Dovgalyuk/RelayComputerKit/README.md

# Релейный конструктор

Скомпилированный учебник и gerber-файлы для изготовления плат:
