Dovgalyuk/RelayComputerKit/labs/labs.tex

\documentclass[openany]{book}

\usepackage[a4paper]{geometry}

\usepackage[T2A]{fontenc}
\usepackage[utf8]{inputenc}
\usepackage[english,russian]{babel}

\usepackage{graphicx}
\usepackage{pdflscape}
\usepackage{amsmath}

\usepackage{ifthen}
\usepackage{suffix}

\begin{document}

\newcounter{adder}
\setcounter{adder}{0}
\newcommand{\incrementadder}[1]{%
\ifthenelse{\theadder < #1}
{\setcounter{adder}{#1}}
{}
}
\newcommand\modulesadder[1]{\incrementadder{#1}$#1$}
\WithSuffix\newcommand\modulesadder*[1]{\incrementadder{#1}}

\newcounter{binary}
\setcounter{binary}{0}
\newcommand{\incrementbinary}[1]{%
\ifthenelse{\thebinary < #1}
{\setcounter{binary}{#1}}
{}
}
\newcommand\modulesbinary[1]{\incrementbinary{#1}$#1$}
\WithSuffix\newcommand\modulesbinary*[1]{\incrementbinary{#1}}

\newcounter{bus}
\setcounter{bus}{0}
\newcommand{\incrementbus}[1]{%
\ifthenelse{\thebus < #1}
{\setcounter{bus}{#1}}
{}
}
\newcommand\modulesbus[1]{\incrementbus{#1}$#1$}
\WithSuffix\newcommand\modulesbus*[1]{\incrementbus{#1}}

\newcounter{cable}
\setcounter{cable}{0}
\newcommand{\incrementcable}[1]{%
\ifthenelse{\thecable < #1}
{\setcounter{cable}{#1}}
{}
}
\newcommand\modulescable[1]{\incrementcable{#1}$#1$}
\WithSuffix\newcommand\modulescable*[1]{\incrementcable{#1}}

\newcounter{clock}
\setcounter{clock}{0}
\newcommand{\incrementclock}[1]{%
\ifthenelse{\theclock < #1}
{\setcounter{clock}{#1}}
{}
}
\newcommand\modulesclock[1]{\incrementclock{#1}$#1$}
\WithSuffix\newcommand\modulesclock*[1]{\incrementclock{#1}}

\newcounter{decoder}
\setcounter{decoder}{0}
\newcommand{\incrementdecoder}[1]{%
\ifthenelse{\thedecoder < #1}
{\setcounter{decoder}{#1}}
{}
}
\newcommand\modulesdecoder[1]{\incrementdecoder{#1}$#1$}
\WithSuffix\newcommand\modulesdecoder*[1]{\incrementdecoder{#1}}

\newcounter{matrix}
\setcounter{matrix}{0}
\newcommand{\incrementmatrix}[1]{%
\ifthenelse{\thematrix < #1}
{\setcounter{matrix}{#1}}
{}
}
\newcommand\modulesmatrix[1]{\incrementmatrix{#1}$#1$}
\WithSuffix\newcommand\modulesmatrix*[1]{\incrementmatrix{#1}}

\newcounter{power}
\setcounter{power}{1}
\newcommand{\incrementpower}[1]{%
\ifthenelse{\thepower < #1}
{\setcounter{power}{#1}}
{}
}
\newcommand\modulespower[1]{\incrementpower{#1}$#1$}
\WithSuffix\newcommand\modulespower*[1]{\incrementpower{#1}}

\newcounter{register}
\setcounter{register}{0}
\newcommand{\incrementregister}[1]{%
\ifthenelse{\theregister < #1}
{\setcounter{register}{#1}}
{}
}
\newcommand\modulesregister[1]{\incrementregister{#1}$#1$}
\WithSuffix\newcommand\modulesregister*[1]{\incrementregister{#1}}

\newcounter{rom}
\setcounter{rom}{0}
\newcommand{\incrementrom}[1]{%
\ifthenelse{\therom < #1}
{\setcounter{rom}{#1}}
{}
}
\newcommand\modulesrom[1]{\incrementrom{#1}$#1$}
\WithSuffix\newcommand\modulesrom*[1]{\incrementrom{#1}}

\newcounter{switches}
\setcounter{switches}{0}
\newcommand{\incrementswitches}[1]{%
\ifthenelse{\theswitches < #1}
{\setcounter{switches}{#1}}
{}
}
\newcommand\modulesswitches[1]{\incrementswitches{#1}$#1$}
\WithSuffix\newcommand\modulesswitches*[1]{\incrementswitches{#1}}

\newcounter{unary}
\setcounter{unary}{0}
\newcommand{\incrementunary}[1]{%
\ifthenelse{\theunary < #1}
{\setcounter{unary}{#1}}
{}
}
\newcommand\modulesunary[1]{\incrementunary{#1}$#1$}
\WithSuffix\newcommand\modulesunary*[1]{\incrementunary{#1}}

\frontmatter

\tableofcontents

%\part{Что такое компьютер и зачем он нам нужен?}

\include{part1/1_intro}

\mainmatter

\part{Собираем релейный калькулятор}

\include{part2/1 binary_code}
\include{part2/2 relay}
\include{part2/3 registers}
\include{part2/4 unary}
\include{part2/5 binary}
\include{part2/5_5 cross}
\include{part2/6 add}
\include{part2/7 sub}
\include{part2/7_5 muldiv}
\include{part2/8 calculator}
\include{part2/9 answers}

\part{Строим релейный компьютер}

\include{part3/1 elements}
\include{part3/2 decoder}
\include{part3/2_1 calculator2}
\include{part3/3 register file}
\include{part3/4 alu}
\include{part3/6 clock}
\include{part3/7 rom}
\include{part3/8 pc}
\include{part3/9 instruction set}
\include{part3/10 instruction decoder}

\chapter{Компьютер}

\part{Приложения}

\appendix

\chapter{Отладка собранных устройств}

Приёмы отладки:
\begin{itemize}
    \item Вместо тактового генератора подключить тумблеры и подавать сигналы по одному.
    \item Подключать к разным выходам модуль унарных логических операций, чтобы наблюдать
          за сигналами на выходе.
    \item Использовать мультиметр, чтобы проверять работу отдельных реле.
\end{itemize}

\chapter{Как самостоятельно собирать модули}

\include{appendix/components}

\end{document}
