Dovgalyuk/RelayComputerKit/labs/part2/4 unary.tex

\chapter{Унарные логические операции}

% Таблицы истинности

\section{Отрицание}

Одна из самых простых операций, которая используется в современных
компьютерах --- это операция отрицания. Она преобразует единицу
в ноль, а ноль в единицу.

Такую логику можно реализовать с помощью нормально замкнутого контакта реле:

\begin{center}

\end{center}

Когда реле выключено, ток может течь через контакт, поэтому на выходе $B$
получается единица. Если же на входе $A$ появляется единица, реле переключается
и ток через нормально замкнутый контакт не течёт. На выходе $B$ теперь ноль.

\section{Копирование}

На схеме выше кроме выхода $B$ с инвертированным значением есть ещё выход~$C$.
Значение, соответствующее этому сигналу, совпадает со значением на входе схемы ($A$).

На первый взгляд это кажется ненужным, ведь можно просто использовать
$A$ везде, где потребуется. Почти всегда так и есть, но как мы позже увидим,
иногда нужно соединить вместе несколько выходных сигналов. И вот тогда,
чтобы они не влияли друг на друга (ведь цепь получается одна),
используется такое <<копирование>>, подобное тому, что на этой схеме.

\section{Сдвиг}

Операция сдвига ещё более простая по сравнению с отрицанием.
Суть её в том, что биты в числе перемещаются по какому-либо
принципу (влево, вправо, по кругу).

В конструкторе реализован сдвиг вправо.
Нулевой бит вытесняется из числа (и может использоваться отдельно).
Первый бит становится нулевым, второй первым и так далее.
Старший бит становится вторым по значимости, а на его место приходит ноль, либо
вытесненный нулевой бит из соседнего модуля.
Такой сдвиг эквивалентен делению на два, поэтому деление на степень двойки в программах
процессор вычисляет с помощью инструкции сдвига.

Для реализации сдвига вправо можно даже не использовать реле:

\begin{center}

\end{center}

В конструкторе есть готовый модуль только для сдвига вправо. Ещё в вычислениях часто используется
сдвиг влево (эквивалентный умножению на два), но его легко реализовать с помощью сложения числа с самим собой.

\section{Модуль унарных логических операций}

Модуль для унарных операций выполняет действия над $4$-битным числом: сдвиг вправо и инверсия битов.
Эти действия выполняются одновременно. То есть с одного выхода можно прочитать сдвинутое число,
а с другого инвертированное. И одновременно записать это в разные регистры.

В дополнение к этому с выходных разъёмов модуля можно считать три копии входного числа.
Там будут такие же сигналы, но полученные с помощью отдельных цепей.

% \begin{center}
% \includegraphics[width=\columnwidth]{schemes_components/unary.png}
% \end{center}

\begin{center}

\end{center}

\begin{center}

\end{center}

Модуль для унарных логических операций имеет следующие разъёмы:
\begin{itemize}
  \item Слева и справа: шины для каскадирования нескольких модулей.
        Можно использовать, когда нужен сдвиг чисел больше четырёх бит.
  \item Сверху: разъёмы для подключения сдвигаемого операнда.
        Можно подсоединить к какой-нибудь шине, а можно к модулю переключателей или регистру.
  \item Снизу: два разъёма с выходными сигналами. На один поступает инвертированный
        операнд, а на другой сдвинутое вправо значение операнда.
  \item Снизу-слева: три разъёма с копиями операнда.
\end{itemize}

\section{Практикум}

Список модулей:
\begin{itemize}
    \item Модуль переключателей: \modulesswitches{2} штуки
    \item Модуль унарных операций: \modulesunary{1} штука
    \item Регистровый модуль: \modulesregister{1} штука
\end{itemize}

На вход модуля унарных операций подключается модуль с тумблерами.
Выходы подключаются к шинам регистра.

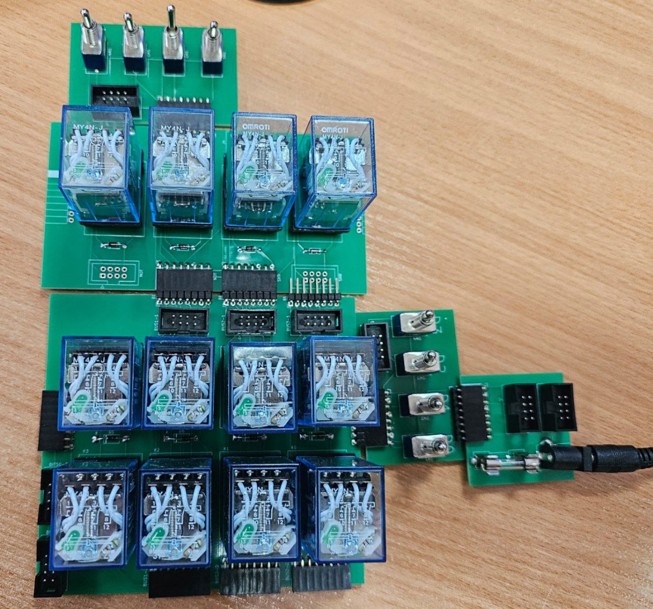
[picture p8: labs/photo/unary.jpg]


\begin{enumerate}
    \item Отключите все управляющие сигналы.
    \item Наберите на тумблерах со входными данными значение $1100$.
    \item Подключите выходной регистр к шине $1$. Убедитесь, что в него записалось значение $0011$ (инверсия).
    \item Отключите регистр от шины, сбросить его значение.
    \item Подключите выходной регистр к шине $2$. Убедитесь, что в него записалось значение $0110$ (сдвиг вправо).
\end{enumerate}

\section{Задачи}

\modulesregister*{2}
\modulescable*{2}

\begin{enumerate}
    \item Соберите устройство для одновременного вычисления сдвига и инверсии. По сигналу с одного тумблера
          оба эти результата должны записаться в два разных регистра.
    \item Соберите устройство, позволяющее сдвигать содержимое регистра и записывать результат обратно.
          Чтобы проверить его работу,
          занесите в регистр значение $1000$ и сдвигайте его (потребуется несколько манипуляций) до тех пор, пока не получится $0001$.
          Придётся использовать два регистровых модуля: с одного считывается операнд, а в другой записывается результат.
          Вторую часть можно выполнять на скорость.
\end{enumerate}
