Dovgalyuk/RelayComputerKit/labs/part2/5_5 cross.tex

\chapter{Коммутация входов и выходов с помощью кросс-модуля}

\section{Кросс-модуль}

Иногда на вход модуля нужно подавать биты не в том же порядке, как получены из другого модуля.
Например, если потребуется вычислить логическое <<И>> с третьим битом одного числа и вторым
битом другого. А наш логический модуль умеет работать только с одноимёнными битами,
причём сразу со всеми четырьмя.

Чтобы <<перемешивать>> биты или передавать куда-то только часть сигналов, можно использовать
кросс-модуль (он же коммутационная матрица). В нём есть два четырёхбитных входа-выхода
(как всегда они работают в обоих направлениях).

Но эти два противоположных разъёма не соединены между собой. Соединения нужно сделать самостоятельно
в зависимости от того, какая задача решается. Для примера выше нужно взять два кросс-модуля.
В одном бит~$0$ входа~$1$ соединить с битом~$3$ входа~$2$, а в другом
бит~$0$ входа~$1$ соединить с битом~$2$ входа~$2$.

И теперь, если подключить входы~$1$ кросс-модулей к логическому модуля,
а потом подать сигналы на входы~$2$, то в нулевых битах выходов логического модуля будут
результаты искомых вычислений.

\section{Практикум}

Список модулей:
\begin{itemize}
    \item Модуль переключателей: \modulesswitches{3} штуки
    \item Модуль унарных логических операций: \modulesbinary{1} штука
    \item Модуль логических операций: \modulesbinary{2} штуки
    \item Кросс-модуль: \modulesmatrix{2} штуки
    \item Шлейф: \modulescable{2} штуки
\end{itemize}

Управлять освещением длинного коридора удобно, когда есть несколько выключателей.
Например, человеку может потребоваться включить
свет, заходя в коридор с одной стороны, а выключить, выходя с другой.
Эту задачу можно решить с помощью механических переключателей (у которых один вход и два выхода),
но мы попробуем собрать аналогичную логическую схему используя только выключатели
(вход один и выход тоже один).

В качестве лампочки будем использовать одно из управляющих реле регистрового модуля.
Схема должна позволять в любой момент зажечь или выключить лампочку переключением любого
из трёх тумблеров.

Построим таблицу истинности для схемы из выключателей и лампочки: входами $A$, $B$, $C$ будут
положения тумблеров, а выходом $R$ --- состояние лампочки.

Сначала всё выключена, поэтому лампочка тоже не горит:

\begin{center}
\begin{tabular}{|c|c|c|c|}
 \hline
 \textbf{A} & \textbf{B} & \textbf{C} & \textbf{R} \\ \hline
 $0$ & $0$ & $0$ & $0$ \\ \hline
\end{tabular}
\end{center}

Если один из тумблеров переключить, лампочка загорится:

\begin{center}
\begin{tabular}{|c|c|c|c|}
 \hline
 \textbf{A} & \textbf{B} & \textbf{C} & \textbf{R} \\ \hline
 $0$ & $0$ & $0$ & $0$ \\ \hline
 $1$ & $0$ & $0$ & $1$ \\ \hline
 $0$ & $1$ & $0$ & $1$ \\ \hline
 $0$ & $0$ & $1$ & $1$ \\ \hline
\end{tabular}
\end{center}

Потом можно выключить уже нажатый тумблер (и вернуться к первой строке таблицы),
а можно <<дойти до конца коридора>> и переключить другой. Лампочка должна погаснуть:

\begin{center}
\begin{tabular}{|c|c|c|c|}
 \hline
 \textbf{A} & \textbf{B} & \textbf{C} & \textbf{R} \\ \hline
 $0$ & $0$ & $0$ & $0$ \\ \hline
 $1$ & $0$ & $0$ & $1$ \\ \hline
 $0$ & $1$ & $0$ & $1$ \\ \hline
 $0$ & $0$ & $1$ & $1$ \\ \hline
 $1$ & $1$ & $0$ & $0$ \\ \hline
 $1$ & $0$ & $1$ & $0$ \\ \hline
 $0$ & $1$ & $1$ & $0$ \\ \hline
\end{tabular}
\end{center}

И остаётся вариант, когда переключены все три тумблера. Так как число переключений нечётное,
лампочка загорается снова:

\begin{center}
\begin{tabular}{|c|c|c|c|}
 \hline
 \textbf{A} & \textbf{B} & \textbf{C} & \textbf{R} \\ \hline
 $0$ & $0$ & $0$ & $0$ \\ \hline
 $1$ & $0$ & $0$ & $1$ \\ \hline
 $0$ & $1$ & $0$ & $1$ \\ \hline
 $0$ & $0$ & $1$ & $1$ \\ \hline
 $1$ & $1$ & $0$ & $0$ \\ \hline
 $1$ & $0$ & $1$ & $0$ \\ \hline
 $0$ & $1$ & $1$ & $0$ \\ \hline
 $1$ & $1$ & $1$ & $1$ \\ \hline
\end{tabular}
\end{center}

Такая таблица истинности соответствует операции <<исключающее или>>, только для трёх операндов
вместо двух. Можете убедиться самостоятельно, что таблица описывает такое выражение:

$$R = A\ xor\ B\ xor\ C = (A\ xor\ B)\ xor\ C = A\ xor\ (B\ xor\ C)$$

Чтобы его <<посчитать>> с помощью модулей конструктора нужно немного подумать.
Логический модуль считает $xor$ для пары четырёхбитных операндов. А у нас тут есть три однобитных.
То есть нужно либо взять два логических модуля, либо подавать сигнал с выхода одного
однобитного $xor$ на вход другого внутри одного и того же модуля.

Первый вариант можно реализовать с помощью такой схемы:

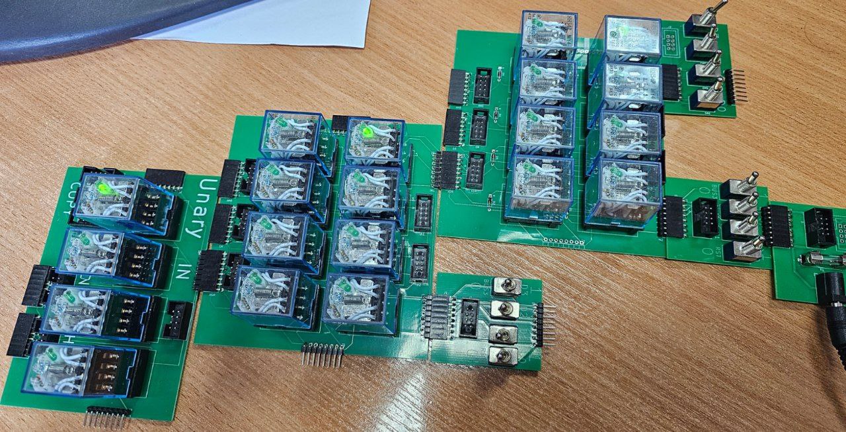
[picture p10: labs/photo/three_switches_xor.jpg]


Тут реализуется формула, приведённая выше: сначала выполняется $A\ xor\ B$,
а потом с полученным результатом делается $xor\ C$.
Каждый из входных битов расположен на своей плате переключателей.
Нужно только выбрать, какой бит использовать, потому что каждый сигнал повторяется $4$ раза, по числу
задействованных тумблеров.
Значение выходного бита показывается с помощью реле на плате модуля унарных операций,
подключенного последним в цепочке модулей.

Чтобы использовать только один логический модуль, понадобится пара кросс-модулей
для перемещения битов с одного места на другое:

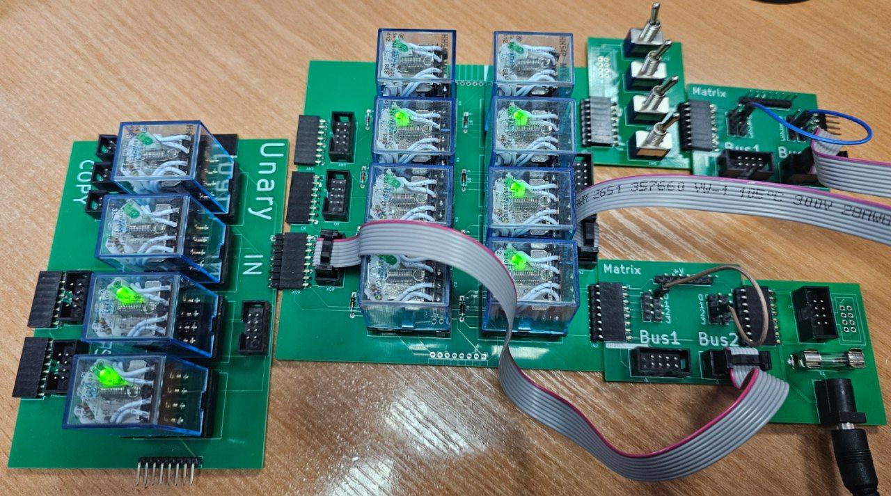
[picture p11: labs/photo/three_switches_xor2.jpg]


Здесь входные данные задаются с помощью трёх тумблеров: $0 - A$, $1 - B$, $2 - C$.
Все сигналы с них подаются на первый вход логического модуля. Но сигнал $B$ мы тут не используем,
а с помощью кросс-модуля перенаправляем его на бит~$2$ второго входа логического модуля.

Получается, что бит~$2$ на выходе будет равен $C\ xor\ B$. С помощью второго кросс-модуля
мы передаём выходной сигнал $xor$ на нулевой бит второго входа. В результате нулевой бит будет равен
$(C\ xor\ B)\ xor\ A$, а чтобы это увидеть, к выходу $xor$ также подключен ещё и модуль унарных операций.
Только теперь нельзя выбрать любой бит для работы, а придётся смотреть результат только в нулевом бите.
Все вычисления в реальности происходят последовательно, но мы этого не заметим,
потому что сигналы распространяются со скоростью света, а реле переключается хоть и помедленнее,
но тоже достаточно быстро.

% -------------------------------------------------------------------------------------------------------
% TODO: низкая наглядность, слишком много соединений для варианта с одной простой коммутационной матрицей
% \subsubsection{Игра <<Кто быстрее>>}

% кнопка для "своей игры"

% Входы ABCD
% Выходы WXYZ

% N = ~W & ~X & ~Y & ~Z
% set W = A & N

% Регистровый модуль для защелкивания результата
% Несколько модулей для формирования правильного порядка сигналов для AND при вычислении N
% Инвертор и AND для сигнала N
% AND для сигналов SET
% Модуль для размножения N
% -------------------------------------------------------------------------------------------------------

% \subsubsection{Игра <<Волк, коза и капуста>>}

% Тумблеры показывают положение волка, козы, капусты и человека.
% Схема показывает ошибку, если позиция запрещённая.
