Dovgalyuk/RelayComputerKit/labs/part2/7 sub.tex

\chapter{Арифметические операции. Вычитание}

\section{Вычитание двоичных чисел}

Вычитание в компьютерах делается с помощью трюков с переполнением.
Что такое $10-7=3$ в нашем четырёхбитном вычислителе?
Это $1010-0111=0011$. Так как разрядов всего $4$, тот же результат
можно получить с помощью сложения.

Вспомним, как работает сумматор. На его выходе всегда четырёхбитное число
и бит переноса. Если увеличивать $1010$, то сначала получится $1011$,
потом $1100$, $1101$, $1110$, $1111$ и наконец $0000$.

То есть мы к $10$ прибавили $5$, получили $15$
($1010+0101=1111$). После прибавления ещё одной единицы должно было бы получиться
$16$ ($10000$), но так как значащих битов всего $4$, пятый бит результата
пропал (точнее, стал сигналом переноса) и осталось значение $0$ ($0000$).

Остаётся увеличить это число на единицу ещё три раза, чтобы получился
правильный ответ~$0011$. Итого, мы прибавили к $10$ число $9$ вместо вычитания $5$
и получили нужный результат.

Следовательно, вместо вычитания $7$ ($0111$) можно прибавлять $9$ ($1001$),
когда речь идёт о четырёхбитных вычислениях.

Такой же фокус можно проделать с любым числом. Быстрый алгоритм
(без циклического прибавления единицы, пока не получится как надо) работает так:
инвертируем все биты числа, а затем прибавляем единицу.

Такое представление отрицательных чисел
называется дополнительным (потому что прибавляли единицу) обратным (потому что инвертировали) кодом.

Число $9$ будет дополнительным обратным кодом для $7$:
из $0111$ сначала получится $1000$, а потом $1001$, что и требовалось.
Работает и в обратную сторону --- из $1001$ инверсией получаем $0110$,
а после добавления единицы будет $0111$.

Таким образом, для вычитания не нужно придумывать новую сложную схему, а достаточно
использовать дополнительный обратный код для второго операнда и уже готовую схему для сложения.

\section{Практикум}

\subsection{Вычитание через сложение с дополнительным обратным кодом}

Список модулей:
\begin{itemize}
    \item Модуль переключателей: \modulesswitches{3} штуки
    \item Сумматор: \modulesadder{1} штука
    \item Регистровый модуль: \modulesregister{1} штука
\end{itemize}

Собрать схему для сложения.
Для вычитания вам нужно вычитаемое представлять в дополнительном обратном
коде.

\begin{enumerate}
    \item Отключите все управляющие сигналы.
    \item Установите перемычку для подачи сигнала на $\textasciitilde CY$ сумматора.
    \item Наберите на тумблерах первого операнда значение $1010$ (число $10$).
    \item Наберите на тумблерах второго операнда значение $1101$ (число $-3$).
    \item Подключите выходной регистр к шине $3$. Убедитесь, что в него записалось значение $0111$ (число $7$).
\end{enumerate}

\subsection{Вычитание с помощью сумматора и инвертора}

Чтобы вручную не переводить второй операнд, а на втором входе сумматора автоматически получался дополнительный
обратный код, сначала нужно преобразовать исходное число с помощью инвертора, а затем прибавить $1$,
включив вход переноса в сумматоре.

Список модулей:
\begin{itemize}
    \item Модуль переключателей: \modulesswitches{3} штуки
    \item Модуль унарных операций: \modulesunary{1} штука
    \item Сумматор: \modulesadder{1} штука
    \item Регистровый модуль: \modulesregister{1} штука
\end{itemize}

Собрать схему для сложения, а затем добавить между тумблерами со вторым операндом
инвертор (выход NOT блока унарной логики):

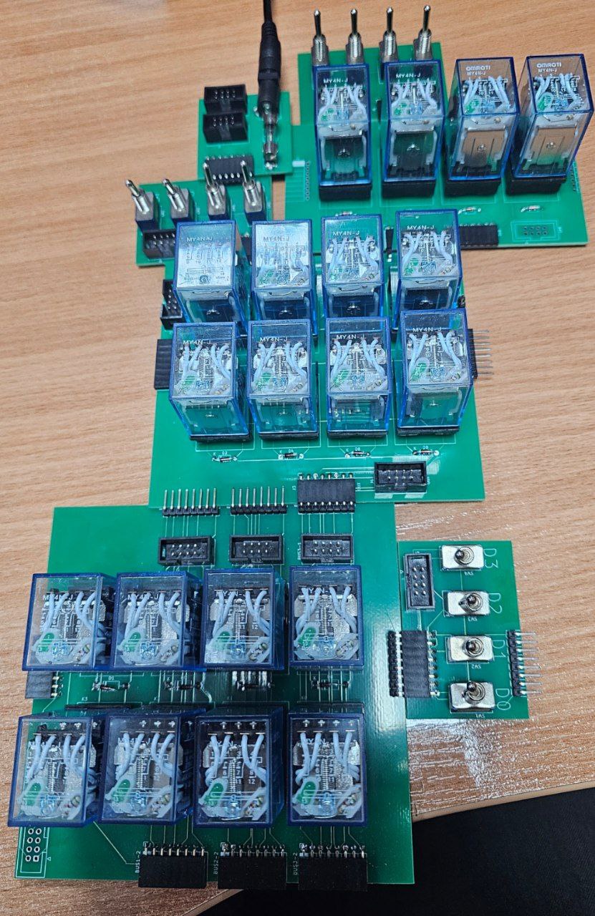
[picture p14: labs/photo/subtractor.jpg]


\begin{enumerate}
    \item Отключите все управляющие сигналы.
    \item Установите перемычку для подачи сигнала на $CY$ сумматора.
    \item Наберите на тумблерах первого операнда значение $1010$ (число $10$).
    \item Наберите на тумблерах второго операнда значение $0011$ (число $3$).
    \item Подключите выходной регистр к шине $3$. Убедитесь, что в него записалось значение $0111$ (число $7$).
\end{enumerate}
