Dovgalyuk/RelayComputerKit/labs/part3/6 clock.tex

\chapter{Тактовый генератор}

\begin{center}

\end{center}

\begin{center}

\end{center}

\section{Бесконечная последовательность сигналов}

\section{Копирование значения в цикле из одного регистра в другой}

\section{Автомат для вычисления чисел Фибоначчи}

b = 1 (делается с помощью тумблеров)

repeat
    c = a + b
    a = b
    b = c

Циклы

1 сбросить c
2 загрузить c = a + b
3 сбросить a
4 загрузить a = b
5 сбросить b
6 загрузить b = c

\subsection{Практикум}

Список модулей:
\begin{itemize}
    \item Тактовый генератор: \modulesclock{2} штуки
    \item Сумматор: \modulesadder{1} штука
    \item Модуль переключателей: \modulesswitches{1} штука
    \item Кросс-модуль: \modulesmatrix{2} штуки
    \item Регистровый модуль: \modulesregister{3} штуки
    \item Соединительный шлейф: \modulescable{9} штук
\end{itemize}

\begin{center}
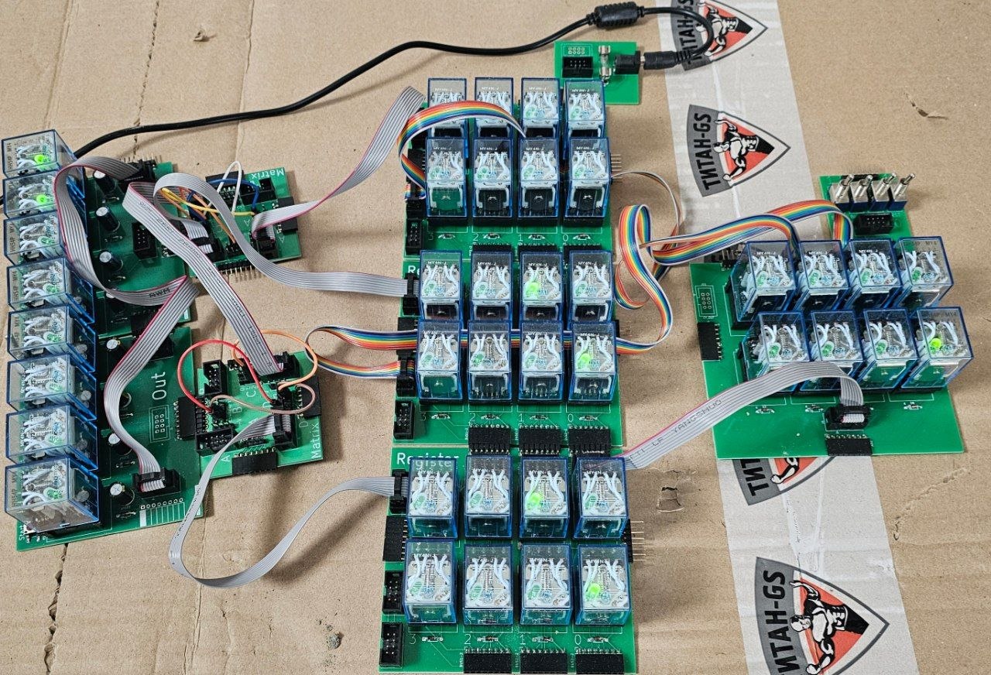
[picture p21: labs/photo/fibonacci1.jpg]

\end{center}
