Dovgalyuk/RelayComputerKit/labs/part3/1 elements.tex

\chapter{Элементы компьютера}

\section{Чем компьютер отличается от калькулятора?}
