Dovgalyuk/RelayComputerKit/labs/part2/1 binary_code.tex

\chapter{Двоичная система счисления}

Так уж получилось, что компьютерам и другим цифровым устройствам
удобнее всего работать в двоичной системе счисления.
Люди привыкли работать с десятичной системой, а компьютеры работают в двоичной.
И раз уж мы планируем позаниматься созданием цифровых игрушек,
компьютеров и калькуляторов, стоит изучить двоичную систему счисления
поподробнее.

Когда мы используем десятичную систему счисления, мы записываем числа с помощью десяти цифр, а у компьютеров
числа <<записаны>> (если так вообще можно говорить) с помощью только двух цифр.
Само число остаётся тем же самым независимо от формы записи. Двенадцать стульев
будут двенадцатью стульями, если их записать как $12$, $XII$ или $1100_2$.

Последний вариант это как раз двоичная запись (о чём нам намекает цифра~$2$ в конце).
В ней используется только две цифры: $1$ и $0$. И этого вполне достаточно, чтобы закодировать
любое число. $0$ записывается как $0$, $1$ будет $1$ (пока всё легко). Чтобы записать $2$
разных цифр уже не хватает, поэтому нужно использовать больше разрядов. Значит $2$ --- это $10$,
$3$ --- $11$, $4$ --- $100$, $5$ --- $101$.

Смысл тут такой же, как и в десятичном счёте. Там если разряд равен $9$ (последняя доступная цифра),
то при увеличении числа он заменяется на $0$, а более старший разряд увеличивается на единицу.
В двоичном счёте самая большая цифра это $1$, поэтому перенос происходит, когда нужно такой разряд
увеличить. Тогда при сложении $11$ и $1$ получается $100$: сначала переполняется младший разряд,
а затем из-за переноса и следующий за ним.

\section{Перевод числа из двоичной системы счисления}

Дальше мы будем часто встречать двоичные числа (например, наш калькулятор
будет показывать именно двоичные числа). Но как их понимать?
Как из двоичной записи получить десятичную?
Можно просто запомнить все нужные значения. Например, $1111_2=15_{10}$.
Но вдруг понадобятся числа больше чем из четырёх разрядов? Неплохо бы понять принцип.

Когда к числу добавляется ноль справа, это то же самое, что умножить исходное число на $10$.
Очевидно это так и для десятичной, и для двоичной систем счисления. Только в десятичной
$10$ это $10$, а в двоичной $10$ это $2$.

Получается, что последовательным домножением единицы на $10_2$ можно получать степени двойки:
$$1_2=2^0=1$$
$$10_2=2^1=2$$
$$100_2=2^2=4$$
$$1000_2=2^3=8$$
$$10000_2=2^4=16$$

А любое двоичное число можно разобрать на полученные выше слагаемые:

$$1101_2=1000_2+100_2+1_2=2^3+2^2+1=8+4+1=13$$

Один разряд двоичного числа называется битом. С помощью одного бита можно закодировать
два варианта чего либо (<<да>> или <<нет>>, <<чёрное>> или <<белое>> и т.п.),
так как такой разряд может содержать либо~$0$, либо~$1$.

% Если точнее, бит --- это единица
% измерения количества информации. Он определяет одну из двух возможностей
% появления взаимно исключающих событий. А если эту информацию
% (выбранное событие) передать или записать где-то, то как раз можно использовать $1$ или $0$.

Если к одному биту добавить ещё один, число возможных комбинаций увеличится
вдвое. Так можно записать информацию о четырёх событиях или состояниях ($00$, $01$, $10$, $11$).
Если взять три бита, то уже о восьми и так далее. Дальше мы будем в основном работать с четырёхбитными
числами, то есть от $0000$ до $1111$ (или от $0$ до $15$).

% В общем виде преобразование двоичного числа $b$, в котором много цифр, выглядит так:
% $$b_nb_{n-1}b_{n-2}\cdots b_2b_1b_0 = \sum_{i\in[0;n]}2^ib_i$$

\section{Перевод числа в двоичную систему счисления}

Если нам нужно в уме перевести десятичное число (например, $18$) в двоичную систему счисления,
то можно действовать так. В начале алгоритма число-результат у нас равняется нулю.
Находим наибольшую степень двойки, которая <<помещается>> в десятичное число (это будет $16=2^4=10000_2$).
Потом вычитаем это число из исходного, а к результату добавляем единицу в нужном разряде
(получится $18-16=2$ и $0+10000_2=10000_2$).
Повторяем эти два шага снова (результатом будет $2-2=0$ и $10000_2+10_2=10010_2$). Исходное число обнулилось,
ничего дальше делать не нужно.

Почему этот способ сработает? Не может ли дважды получиться единица в одном и том же месте?
Оказывается нет, потому что степень двойки умноженная на два (если два раза вычитать одно и то же),
это будет следующая степень двойки. А мы ведь вычитали наибольшую из возможных степеней, поэтому
такого быть не может.

Этот способ неплох, но на практике часто делают наоборот --- находят разряды результата начиная
с младшего из них. Как найти самый младший разряд? Если посмотреть на двоичную запись,
то становится очевидным, что этот разряд будет равен остатку от деления на $10_2$.
Чтобы этот разряд теперь отбросить и перейти к следующему, всё число нужно разделить на $10_2$.

Делим $18$ на $10_2=2$: младшая цифра (остаток) будет $0$, частное равно $9$.
Проделаем это несколько раз:
\begin{center}
\begin{tabular}{cccc}
$18 : 2$ & $=$ & $9$ & (остаток $0$) \\
$9 : 2$ & $=$ & $4$ & (остаток $1$) \\
$4 : 2$ & $=$ & $2$ & (остаток $0$) \\
$2 : 2$ & $=$ & $1$ & (остаток $0$) \\
$1 : 2$ & $=$ & $0$ & (остаток $1$) \\
\end{tabular}
\end{center}

Теперь выписываем полученные остатки, начиная с последнего, и получаем двоичную
запись числа~$18$: $10010$.

\section{Двоичная логика}

Компьютеры должны не только хранить числа, но и ещё что-то делать с ними.
Люди обычно пользуются сложением, вычитанием, умножением и делением.
Для процессора эти действия слишком сложные, поэтому они выполняются
на основе более простых операций.

Операции выполняются над двоичными числами. То есть у каждой
есть один или несколько операндов-двоичных чисел, а результатом обычно будет одно число
(ну и может иногда ещё пара дополнительных битов).

Элементарные операции, из которых можно построить более сложные,
вообще оперируют единичными битами. Например, два бита-операнда
на входе и один бит-результат на выходе.

Чтобы описать, как работает операция, обычно приводят
так называемую таблицу истинности. В ней для каждой комбинации значений
операндов ($A$ и $B$) записан результат операции ($R$). Примерно так:

\begin{center}
\begin{tabular}{|c|c|c|}
 \hline
 \textbf{A} & \textbf{B} & \textbf{R} \\ \hline
 $0$ & $0$ & $0$ \\ \hline
 $1$ & $0$ & $1$ \\ \hline
 $0$ & $1$ & $1$ \\ \hline
 $1$ & $1$ & $1$ \\ \hline
\end{tabular}
\end{center}

Например, вторая строка таблицы означает, что если $A=1$ и $B=0$, то результатом~$R$ будет~$1$.

Вариантов таких операций (и соответственно таблиц) всего $16$ (по числу комбинаций единиц и нулей на выходе).
В реальности используются не все из них. Некоторые (самые полезные) мы сейчас рассмотрим.

Самая простая операция (или оператор) --- это отрицание. У неё только один операнд и она
меняет его значение на обратное. Записывать эту операцию мы будем как $not\ A$,
$\neg A$ или $\mbox{\textasciitilde}A$.

\begin{center}
\begin{tabular}{|c|c|}
 \hline
 \textbf{A} & \textbf{\textasciitilde A} \\ \hline
 $0$ & $1$ \\ \hline
 $1$ & $0$ \\ \hline
\end{tabular}
\end{center}

Логическое <<или>> (дизъюнкция, логическое сложение) выдаёт в качестве результата единицу,
если хотя бы один из операндов равен единице (немного отличается от обычного сложения,
потому что из~$1$ и~$1$ не получается~$2$). Обозначается такой оператор как $A\ or\ B$, $A \vee B$
или $A\ |\ B$.

\begin{center}
\begin{tabular}{|c|c|c|}
 \hline
 \textbf{A} & \textbf{B} & \textbf{A | B} \\ \hline
 $0$ & $0$ & $0$ \\ \hline
 $1$ & $0$ & $1$ \\ \hline
 $0$ & $1$ & $1$ \\ \hline
 $1$ & $1$ & $1$ \\ \hline
\end{tabular}
\end{center}

Логическое <<и>> (конъюнкция, логическое умножение) выдаёт единицу только если на обоих
входах будет единица (и правда похоже на умножение). Обозначаться такой
оператор может как $A\ and\ B$, $A \wedge B$ или $A\ \mbox{\&}\ B$.

\begin{center}
\begin{tabular}{|c|c|c|}
 \hline
 \textbf{A} & \textbf{B} & \textbf{A \& B} \\ \hline
 $0$ & $0$ & $0$ \\ \hline
 $1$ & $0$ & $0$ \\ \hline
 $0$ & $1$ & $0$ \\ \hline
 $1$ & $1$ & $1$ \\ \hline
\end{tabular}
\end{center}

Для создания компьютера перечисленных операций уже достаточно. Но если процессор будет делать
ещё некоторые другие, то будет удобнее писать программы (или создавать аппаратные устройства,
используя те же схемы).

Одной из таких дополнительных операций будет <<исключающее или>> (сложение по модулю~$2$, оператор неравенства).
Она даёт нам единицу только для случаев,
когда один операнд не совпадает с другим (то есть в одном единица, а в другом
ноль)\footnote{С помощью <<исключающего или>> компьютеры делают простейший контроль корректности передачи данных.
Вместо, к примеру, восьми бит числа, которое нужно передать, в канал связи отправляется девять.
Девятый бит (бит чётности) выбирается таким образом, чтобы в полученном девятибитном числе было чётное число
единиц. И если принимающая сторона увидит, что число таких бит нечётно, значит произошла ошибка.
А вычислить значение бита чётности можно применив <<исключающее или>> ко всем значащим битам передаваемого числа.}.
Второе название, сложение по модулю~$2$, означает, что результатом будет последняя цифра суммы операндов
(в двоичном виде, естественно).
Обозначается эта операция как $A\ xor\ B$, $A \oplus B$ или $A\ \mbox{\textasciicircum}\ B$.

\begin{center}
\begin{tabular}{|c|c|c|}
 \hline
 \textbf{A} & \textbf{B} & \textbf{A \textasciicircum{} B} \\ \hline
 $0$ & $0$ & $0$ \\ \hline
 $1$ & $0$ & $1$ \\ \hline
 $0$ & $1$ & $1$ \\ \hline
 $1$ & $1$ & $0$ \\ \hline
\end{tabular}
\end{center}

С помощью логических операций компьютеры могут вычислять принимать решения вроде <<если число равно нулю>> И <<выполняется команда деления>>,
то зажечь лампочку <<ошибка>>.
Конечно, это слишком элементарные операции (да ещё и с однобитовыми числами).
Как делать что-то сложнее, например сложение или вычитание, мы узнаем позднее.

Но нельзя не упомянуть ещё одну важную операцию, на которой строятся вычисления в современных
компьютерах. Правда, в релейном конструкторе её нет, но эта технология не слишком-то современная.

Это операция <<и-не>>, то есть логическое умножение в паре с отрицанием (ещё она называется штрихом Шеффера):

\begin{center}
\begin{tabular}{|c|c|c|}
 \hline
 \textbf{A} & \textbf{B} & \textbf{\textasciitilde(A \& B)} \\ \hline
 $0$ & $0$ & $1$ \\ \hline
 $1$ & $0$ & $1$ \\ \hline
 $0$ & $1$ & $1$ \\ \hline
 $1$ & $1$ & $0$ \\ \hline
\end{tabular}
\end{center}

Оказывается, с помощью одной этой операции можно выразить любую другую.
Обозначим здесь <<и-не>> с помощью кружочка~$\circ$:

\begin{itemize}
    \item $\mbox{\textasciitilde}A = A \circ A$
    \item $A\ \mbox{\&}\ B = \mbox{\textasciitilde}(A \circ B)$
    \item $A\ |\ B = \mbox{\textasciitilde}A \circ \mbox{\textasciitilde}B$
\end{itemize}

% И так удачно совпало, что эту операцию очень легко реализовать <<в железе>>
% с помощью транзисторов (и микросхем, внутри которых тоже транзисторы).

\section{Задачи}

\begin{enumerate}
    \item Напишите программу для перевода числа из десятичной системы в двоичную
          на любом известном вам языке программирования.
    \item Придумайте как вычислять <<исключающее или>> используя только <<и-не>>.
    \item Найдите другую операцию (кроме <<и-не>>), которую можно использовать
          несколько раз в одном выражении, чтобы получить все остальные операции
          (<<и>>, <<или>>, <<не>>, <<исключающее или>>).
\end{enumerate}
