Dovgalyuk/RelayComputerKit/(commit log)

2025-08-23 Rework the structure and add boards
    [and.kicad_sch, operations.kicad_pcb, operations.kicad_sch, or1.kicad_sch, or2.kicad_sch, xor.kicad_sch]
2025-08-31 Many updates
    [add.kicad_sch, bus.kicad_sch, diode.kicad_sch, not.kicad_sch, one_relay.kicad_sch, operations.kicad_sch, registers.kicad_pcb, registers.kicad_sch]
2025-10-13 Some structure updates
    [add.kicad_sch, and.kicad_sch, bus.kicad_sch, diode.kicad_sch, not.kicad_sch, one_relay.kicad_sch, or2.kicad_sch, trigger1.kicad_sch]
2026-01-08 Many fixes
    [registers.kicad_sch, trigger1.kicad_sch, trigger2.kicad_sch, trigger3.kicad_sch]
2026-03-12 Added register board to the repository
    [register-B_Cu.gbr, register-B_Mask.gbr, register-B_Paste.gbr, register-B_Silkscreen.gbr, register-Edge_Cuts.gbr, register-F_Cu.gbr, register-F_Mask.gbr, register-F_Paste.gbr]
2026-03-24 Added some modules
    [logic_unary-B_Cu.gbr, logic_unary-B_Mask.gbr, logic_unary-B_Paste.gbr, logic_unary-B_Silkscreen.gbr, logic_unary-Edge_Cuts.gbr, logic_unary-F_Cu.gbr, logic_unary-F_Mask.gbr, logic_unary-F_Paste.gbr]
2026-03-24 Added more schematics
    [decoder-B_Cu.gbr, decoder-B_Mask.gbr, decoder-B_Paste.gbr, decoder-B_Silkscreen.gbr, decoder-Edge_Cuts.gbr, decoder-F_Cu.gbr, decoder-F_Mask.gbr, decoder-F_Paste.gbr]
2026-04-09 Added power module
    [decoder-B_Cu.gbr, decoder-B_Mask.gbr, decoder-B_Paste.gbr, decoder-B_Silkscreen.gbr, decoder-Edge_Cuts.gbr, decoder-F_Cu.gbr, decoder-F_Mask.gbr, decoder-F_Paste.gbr]
2026-04-16 Added bus module
    [bus-B_Cu.gbr, bus-B_Mask.gbr, bus-B_Paste.gbr, bus-B_Silkscreen.gbr, bus-Edge_Cuts.gbr, bus-F_Cu.gbr, bus-F_Mask.gbr, bus-F_Paste.gbr]
2026-04-16 Added switchboard module
    [bus-B_Cu.gbr, bus-B_Mask.gbr, bus-B_Paste.gbr, bus-B_Silkscreen.gbr, bus-Edge_Cuts.gbr, bus-F_Cu.gbr, bus-F_Mask.gbr, bus-F_Paste.gbr]
2026-04-21 Added new switchboard
    [bus-B_Cu.gbr, bus-B_Mask.gbr, bus-B_Paste.gbr, bus-B_Silkscreen.gbr, bus-Edge_Cuts.gbr, bus-F_Cu.gbr, bus-F_Mask.gbr, bus-F_Paste.gbr]
2026-07-10 Updated boards
    [bus-B_Cu.gbr, bus-B_Mask.gbr, bus-B_Paste.gbr, bus-B_Silkscreen.gbr, bus-Edge_Cuts.gbr, bus-F_Cu.gbr, bus-F_Mask.gbr, bus-F_Paste.gbr]
2026-09-22 Updated actions
    [bus-B_Cu.gbr, bus-B_Mask.gbr, bus-B_Paste.gbr, bus-B_Silkscreen.gbr, bus-Edge_Cuts.gbr, bus-F_Cu.gbr, bus-F_Mask.gbr, bus-F_Paste.gbr]
2026-09-22 Removed gerber from git
    [bus-B_Cu.gbr, bus-B_Mask.gbr, bus-B_Paste.gbr, bus-B_Silkscreen.gbr, bus-Edge_Cuts.gbr, bus-F_Cu.gbr, bus-F_Mask.gbr, bus-F_Paste.gbr]
2026-09-22 Removed generated files
    [adder.kicad_pcb, adder.kicad_sch]
2026-10-26 Added BOM calculation
